jamenaso/PBC_TPF_jmena/PBC_TP_Final_JMena.kicad_pcb

## KiCad design PBC_TP_Final_JMena.kicad_pcb (2018-11-15)

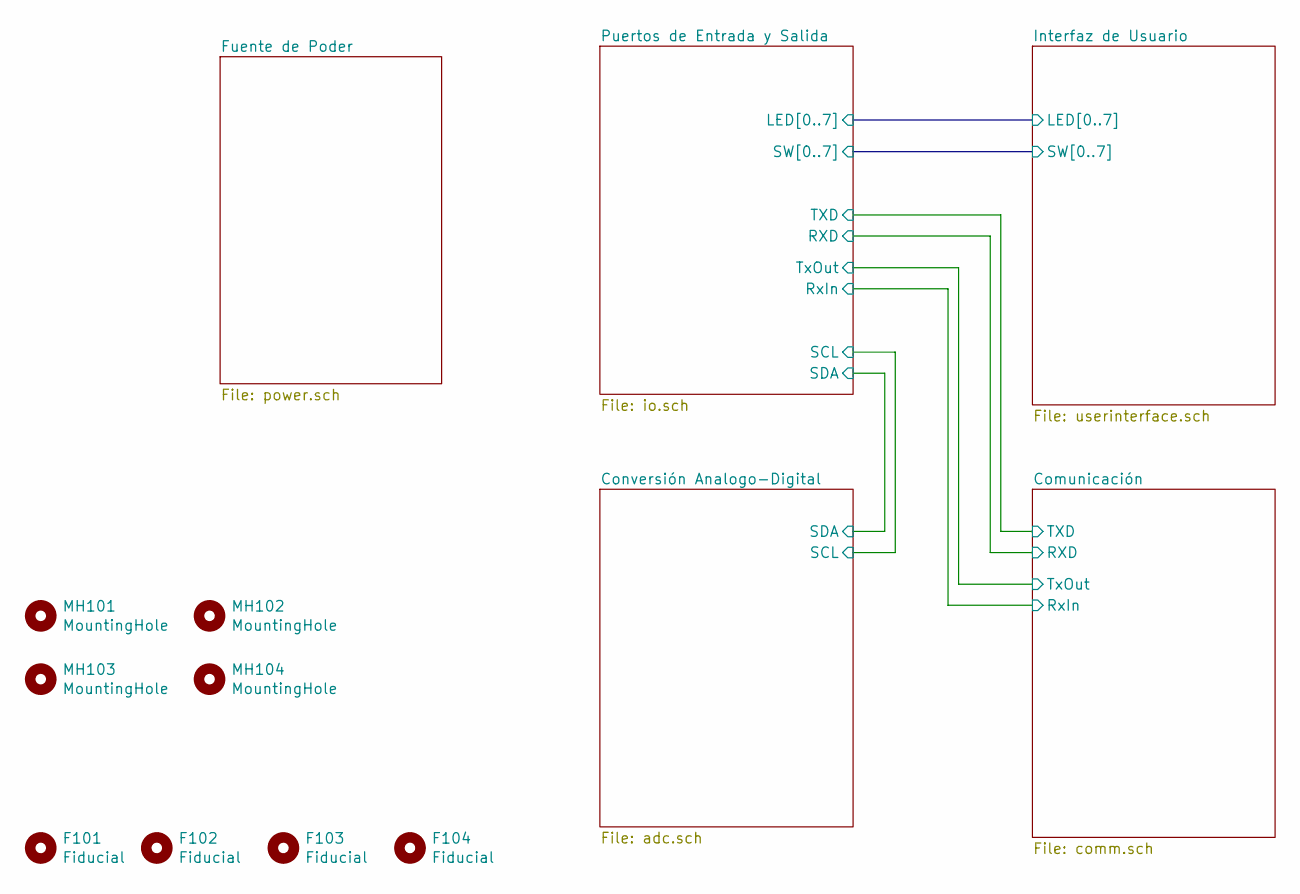
[picture p1: schematic PBC_TP_Final_JMena.sch, PBC TP Final - Tarjeta de Expanción GEO-HCAL]

Parts:
F101, F102, F103, F104: Fiducial; Fiducial_0.75mm_Dia_1.5mm_Outer
MH101, MH102, MH103, MH104: MountingHole; MountingHole_2.5mm

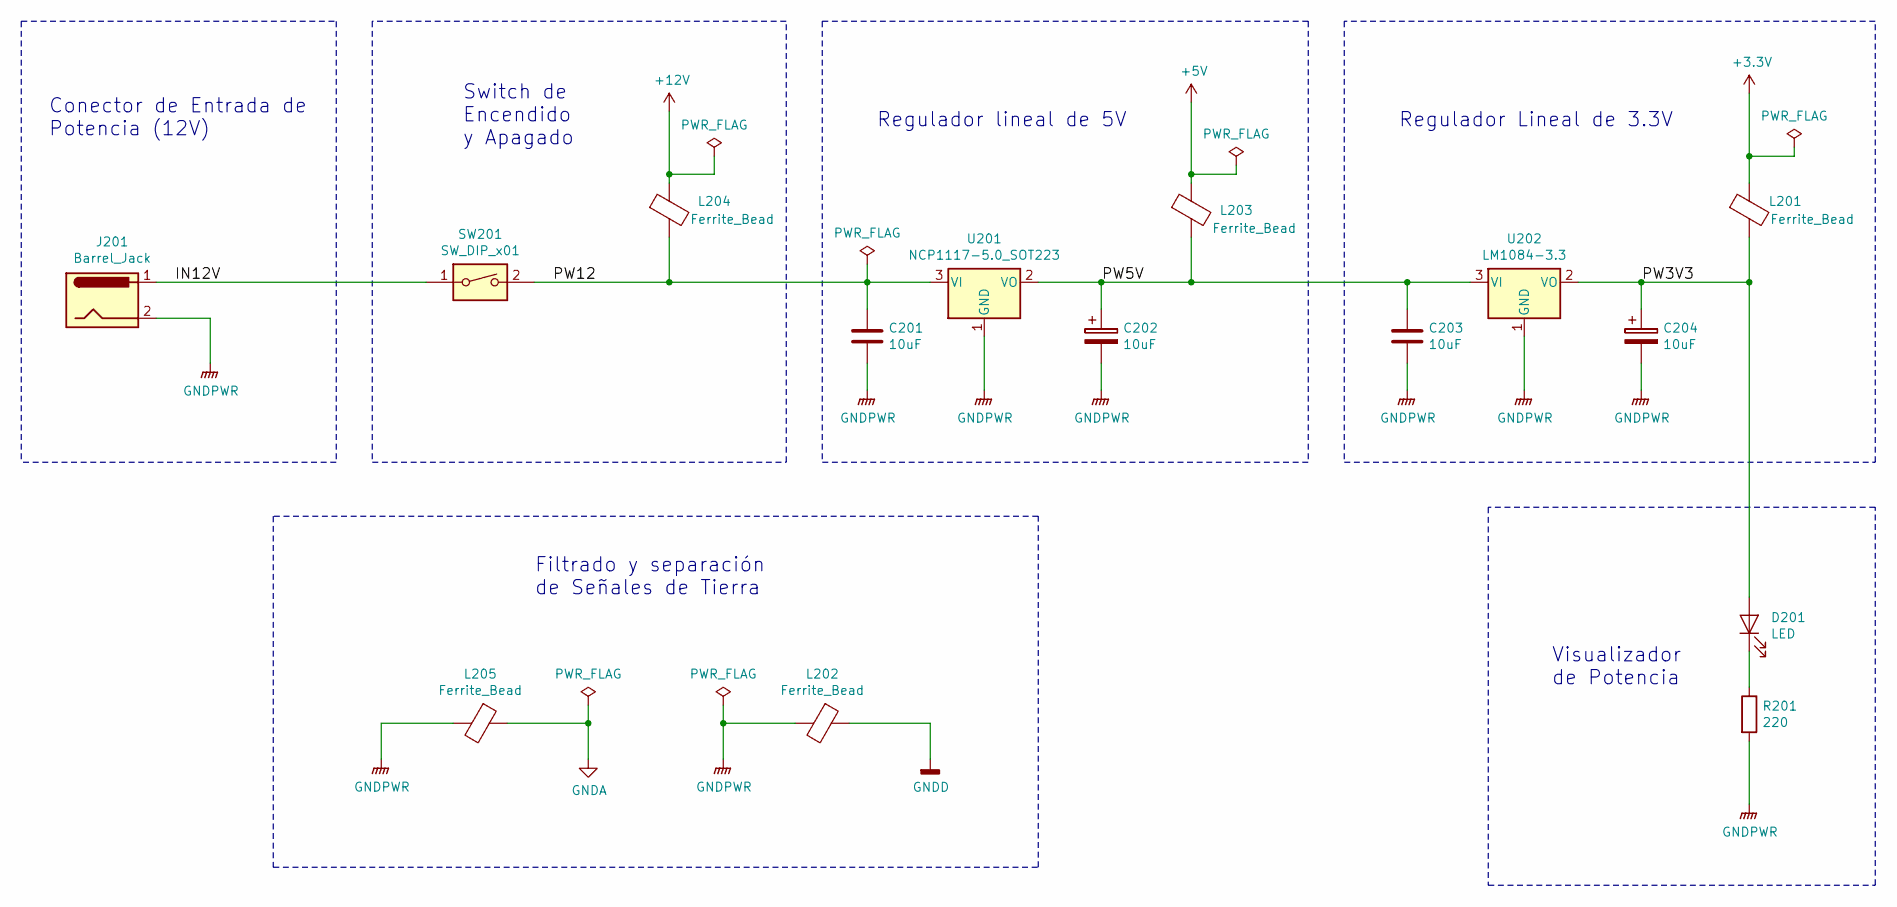
[picture p2: schematic power.sch, PBC TP Final - Tarjeta de Expanción GEO-HCAL]

Parts:
C201, C202, C203, C204: 10uF; C_1206_3216Metric_Pad1.42x1.75mm_HandSolder
D201: LED; LED_0805_2012Metric_Pad1.15x1.40mm_HandSolder
J201: Barrel_Jack; BarrelJack_CUI_PJ-063AH_Horizontal
L201, L202, L203, L204, L205: Ferrite_Bead; L_1206_3216Metric_Pad1.42x1.75mm_HandSolder
R201: 220; R_0805_2012Metric_Pad1.15x1.40mm_HandSolder
SW201: SW_DIP_x01; SW_SPST_EVQPE1
U201: NCP1117-5.0_SOT223; SOT-223-3_TabPin2
U202: LM1084-3.3; TO-263-3_TabPin2

Connections:
+5V: L203.1; also elsewhere on the board
+12V: L204.1; also elsewhere on the board
/Fuente de Poder/IN12V: J201.1, SW201.1
/Fuente de Poder/PW3V3: C204.1, D201.2 (A), L201.2, U202.2 (VO)
/Fuente de Poder/PW5V: C202.1, C203.1, L203.2, U201.2 (VO), U202.3 (VI)
/Fuente de Poder/PW12: C201.1, L204.2, SW201.2, U201.3 (VI)
GNDA: L205.1; also elsewhere on the board
GNDD: L202.1; also elsewhere on the board
GNDPWR: C201.2, C202.2, C203.2, C204.2, J201.2, L202.2, L205.2, R201.2, U201.1 (GND), U202.1 (GND)
unnamed: D201.1 (K), R201.1

Notes on the sheet:
Conector de Entrada de Potencia (12V)
Regulador lineal de 5V
Regulador Lineal de 3.3V
Visualizador de Potencia
Filtrado y separación de Señales de Tierra
Switch de Encendido y Apagado

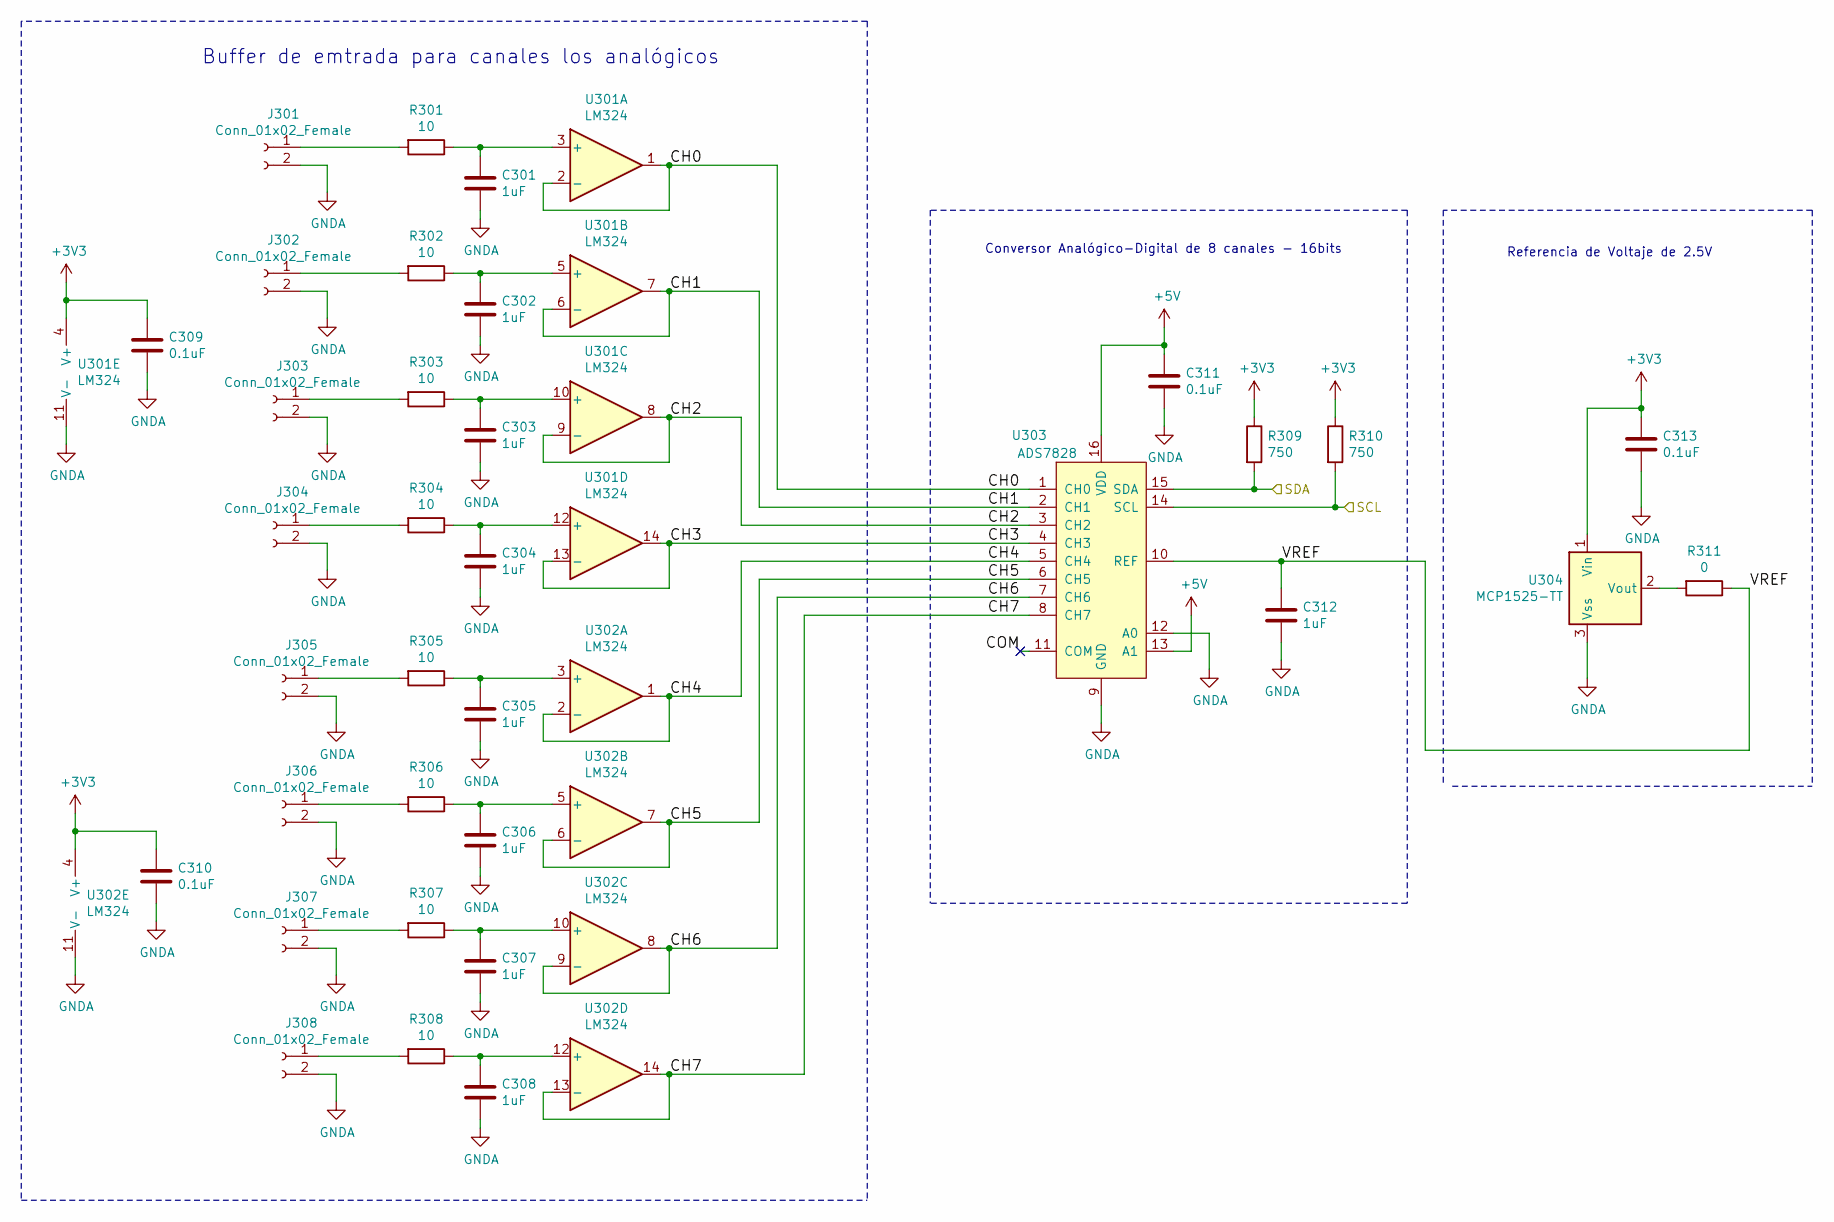
[picture p3: schematic adc.sch, PBC TP Final - Tarjeta de Expanción GEO-HCAL]

Parts:
C301, C302, C303, C304, C305, C306, C307, C308, C312: 1uF; C_0805_2012Metric_Pad1.15x1.40mm_HandSolder
C309, C310, C311, C313: 0.1uF; C_0805_2012Metric_Pad1.15x1.40mm_HandSolder
J301, J302, J303, J304, J305, J306, J307, J308: Conn_01x02_Female; PinHeader_1x02_P1.27mm_Vertical
R301, R302, R303, R304, R305, R306, R307, R308: 10; R_0805_2012Metric_Pad1.15x1.40mm_HandSolder
R309, R310: 750; R_0805_2012Metric_Pad1.15x1.40mm_HandSolder
R311: 0; R_0805_2012Metric_Pad1.15x1.40mm_HandSolder
U301, U302: LM324; SOIC-14_3.9x8.7mm_P1.27mm
U303: ADS7828; TSSOP-16_4.4x5mm_P0.65mm
U304: MCP1525-TT; SOT-23

Connections:
+5V: C311.1, U303.13 (A1), U303.16 (VDD); also elsewhere on the board
/Conversión Analogo-Digital/CH0: U301.1, U301.2 (-), U303.1 (CH0)
/Conversión Analogo-Digital/CH1: U301.6 (-), U301.7, U303.2 (CH1)
/Conversión Analogo-Digital/CH2: U301.8, U301.9 (-), U303.3 (CH2)
/Conversión Analogo-Digital/CH3: U301.13 (-), U301.14, U303.4 (CH3)
/Conversión Analogo-Digital/CH4: U302.1, U302.2 (-), U303.5 (CH4)
/Conversión Analogo-Digital/CH5: U302.6 (-), U302.7, U303.6 (CH5)
/Conversión Analogo-Digital/CH6: U302.8, U302.9 (-), U303.7 (CH6)
/Conversión Analogo-Digital/CH7: U302.13 (-), U302.14, U303.8 (CH7)
/Conversión Analogo-Digital/COM: U303.11 (COM)
/Conversión Analogo-Digital/SCL: R310.2, U303.14 (SCL); also elsewhere on the board
/Conversión Analogo-Digital/SDA: R309.2, U303.15 (SDA); also elsewhere on the board
/Conversión Analogo-Digital/VREF: C312.1, R311.1, U303.10 (REF)
GNDA: C301.2, C302.2, C303.2, C304.2, C305.2, C306.2, C307.2, C308.2, C309.2, C310.2, C311.2, C312.2, C313.2, J301.2, J302.2, J303.2, J304.2, J305.2, J306.2, J307.2, J308.2, U301.11 (V-), U302.11 (V-), U303.9 (GND), U303.12 (A0), U304.3 (Vss); also elsewhere on the board
unnamed: C301.1, R301.1, U301.3 (+)
unnamed: C302.1, R302.1, U301.5 (+)
unnamed: C303.1, R303.1, U301.10 (+)
unnamed: C304.1, R304.1, U301.12 (+)
unnamed: C305.1, R305.1, U302.3 (+)
unnamed: C306.1, R306.1, U302.5 (+)
unnamed: C307.1, R307.1, U302.10 (+)
unnamed: C308.1, R308.1, U302.12 (+)
unnamed: J301.1, R301.2
unnamed: J302.1, R302.2
unnamed: J303.1, R303.2
unnamed: J304.1, R304.2
unnamed: J305.1, R305.2
unnamed: J306.1, R306.2
unnamed: J307.1, R307.2
unnamed: J308.1, R308.2
unnamed: R311.2, U304.2 (Vout)

Notes on the sheet:
Buffer de emtrada para canales los analógicos
Conversor Analógico-Digital de 8 canales - 16bits
Referencia de Voltaje de 2.5V

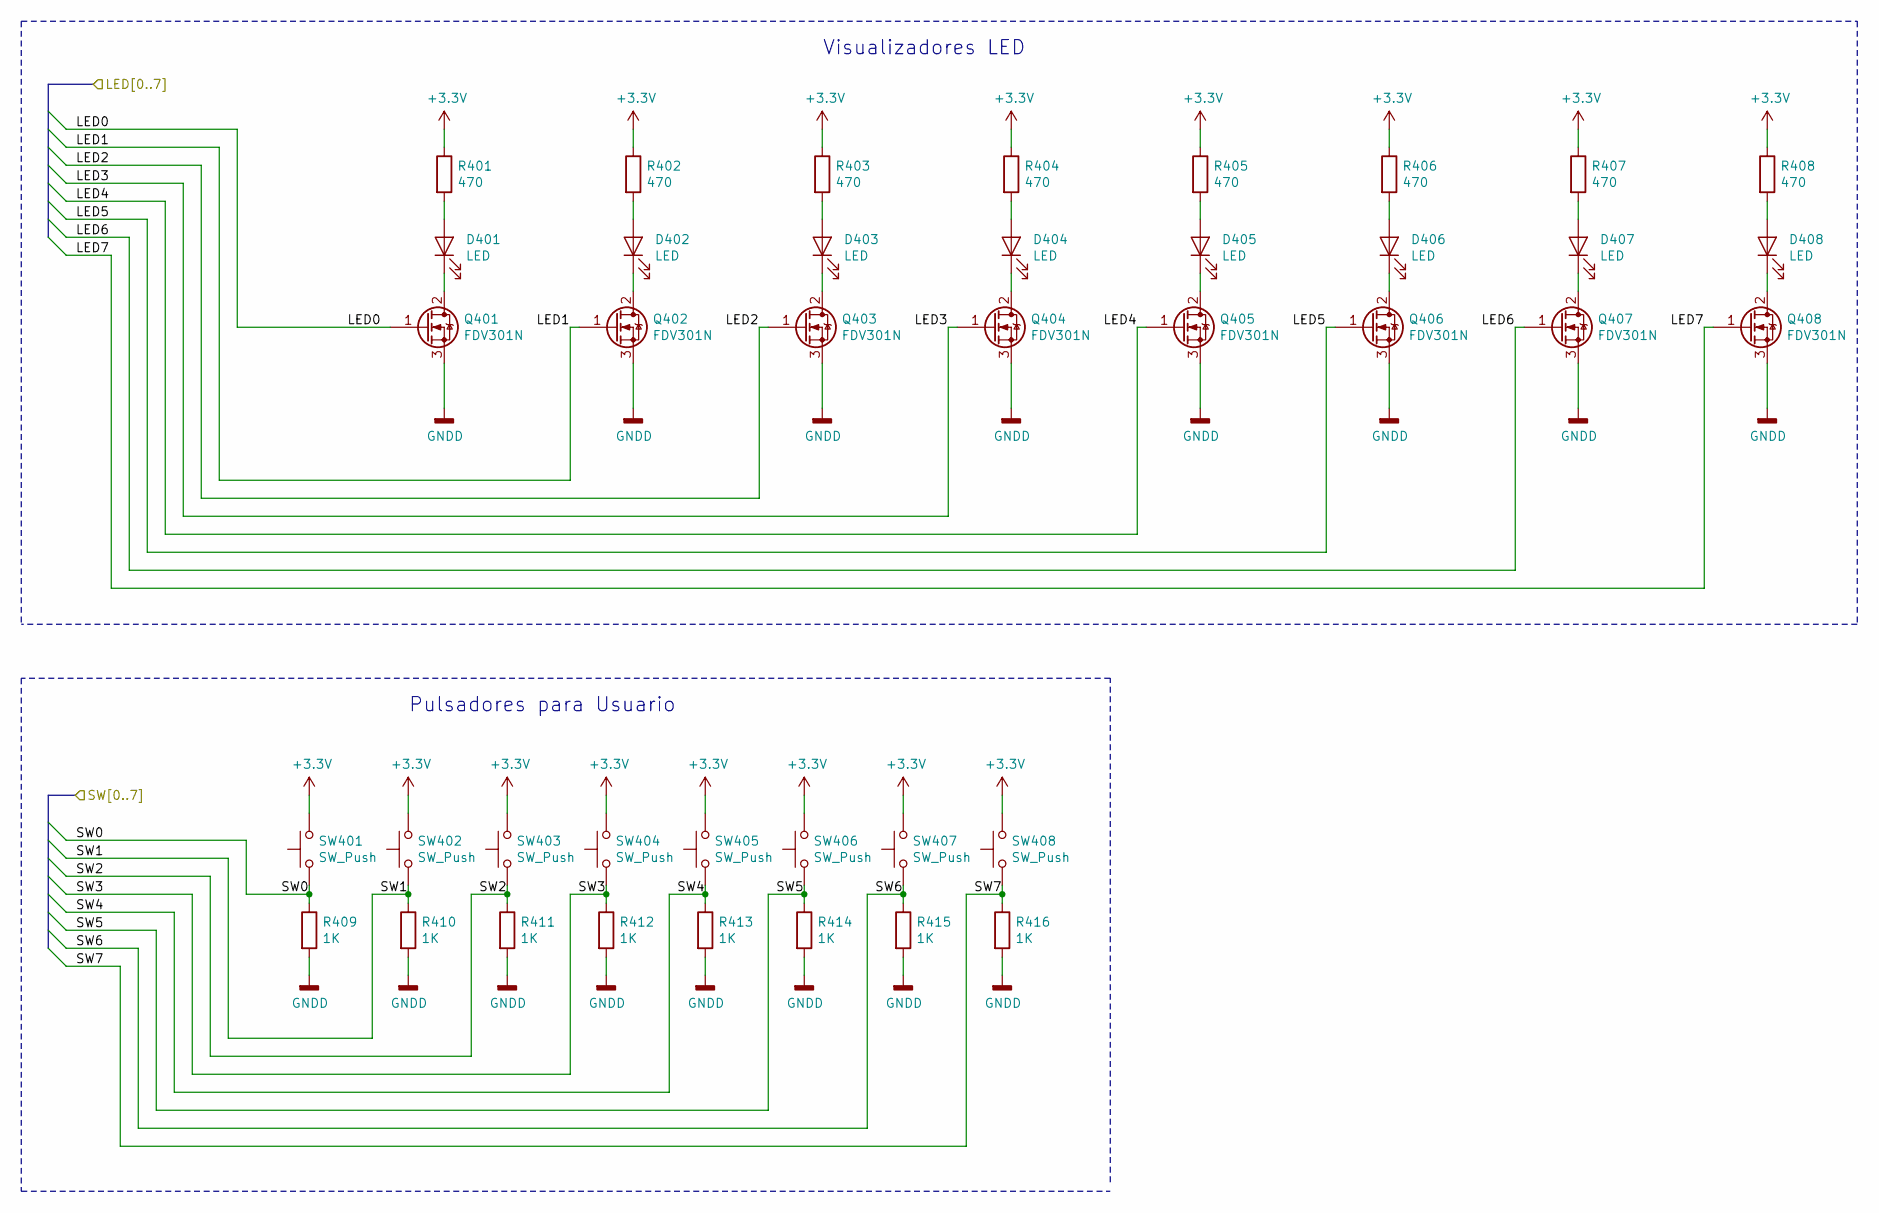
[picture p4: schematic userinterface.sch, PBC TP Final - Tarjeta de Expanción GEO-HCAL]

Parts:
D401, D402, D403, D404, D405, D406, D407, D408: LED; LED_0805_2012Metric_Pad1.15x1.40mm_HandSolder
Q401, Q402, Q403, Q404, Q405, Q406, Q407, Q408: FDV301N; SOT-23
R401, R402, R403, R404, R405, R406, R407, R408: 470; R_0805_2012Metric_Pad1.15x1.40mm_HandSolder
R409, R410, R411, R412, R413, R414, R415, R416: 1K; R_0805_2012Metric_Pad1.15x1.40mm_HandSolder
SW401, SW402, SW403, SW404, SW405, SW406, SW407, SW408: SW_Push; SW_SPST_B3U-1000P

Connections:
/Interfaz de Usuario/LED0: Q401.1 (G); also elsewhere on the board
/Interfaz de Usuario/LED1: Q402.1 (G); also elsewhere on the board
/Interfaz de Usuario/LED2: Q403.1 (G); also elsewhere on the board
/Interfaz de Usuario/LED3: Q404.1 (G); also elsewhere on the board
/Interfaz de Usuario/LED4: Q405.1 (G); also elsewhere on the board
/Interfaz de Usuario/LED5: Q406.1 (G); also elsewhere on the board
/Interfaz de Usuario/LED6: Q407.1 (G); also elsewhere on the board
/Interfaz de Usuario/LED7: Q408.1 (G); also elsewhere on the board
/Interfaz de Usuario/SW0: R409.1, SW401.1; also elsewhere on the board
/Interfaz de Usuario/SW1: R410.1, SW402.1; also elsewhere on the board
/Interfaz de Usuario/SW2: R411.1, SW403.1; also elsewhere on the board
/Interfaz de Usuario/SW3: R412.1, SW404.1; also elsewhere on the board
/Interfaz de Usuario/SW4: R413.1, SW405.1; also elsewhere on the board
/Interfaz de Usuario/SW5: R414.1, SW406.1; also elsewhere on the board
/Interfaz de Usuario/SW6: R415.1, SW407.1; also elsewhere on the board
/Interfaz de Usuario/SW7: R416.1, SW408.1; also elsewhere on the board
GNDD: Q401.3 (S), Q402.3 (S), Q403.3 (S), Q404.3 (S), Q405.3 (S), Q406.3 (S), Q407.3 (S), Q408.3 (S), R409.2, R410.2, R411.2, R412.2, R413.2, R414.2, R415.2, R416.2; also elsewhere on the board
unnamed: D401.1 (K), Q401.2 (D)
unnamed: D401.2 (A), R401.2
unnamed: D402.1 (K), Q402.2 (D)
unnamed: D402.2 (A), R402.2
unnamed: D403.1 (K), Q403.2 (D)
unnamed: D403.2 (A), R403.2
unnamed: D404.1 (K), Q404.2 (D)
unnamed: D404.2 (A), R404.2
unnamed: D405.1 (K), Q405.2 (D)
unnamed: D405.2 (A), R405.2
unnamed: D406.1 (K), Q406.2 (D)
unnamed: D406.2 (A), R406.2
unnamed: D407.1 (K), Q407.2 (D)
unnamed: D407.2 (A), R407.2
unnamed: D408.1 (K), Q408.2 (D)
unnamed: D408.2 (A), R408.2

Notes on the sheet:
Visualizadores LED
Pulsadores para Usuario

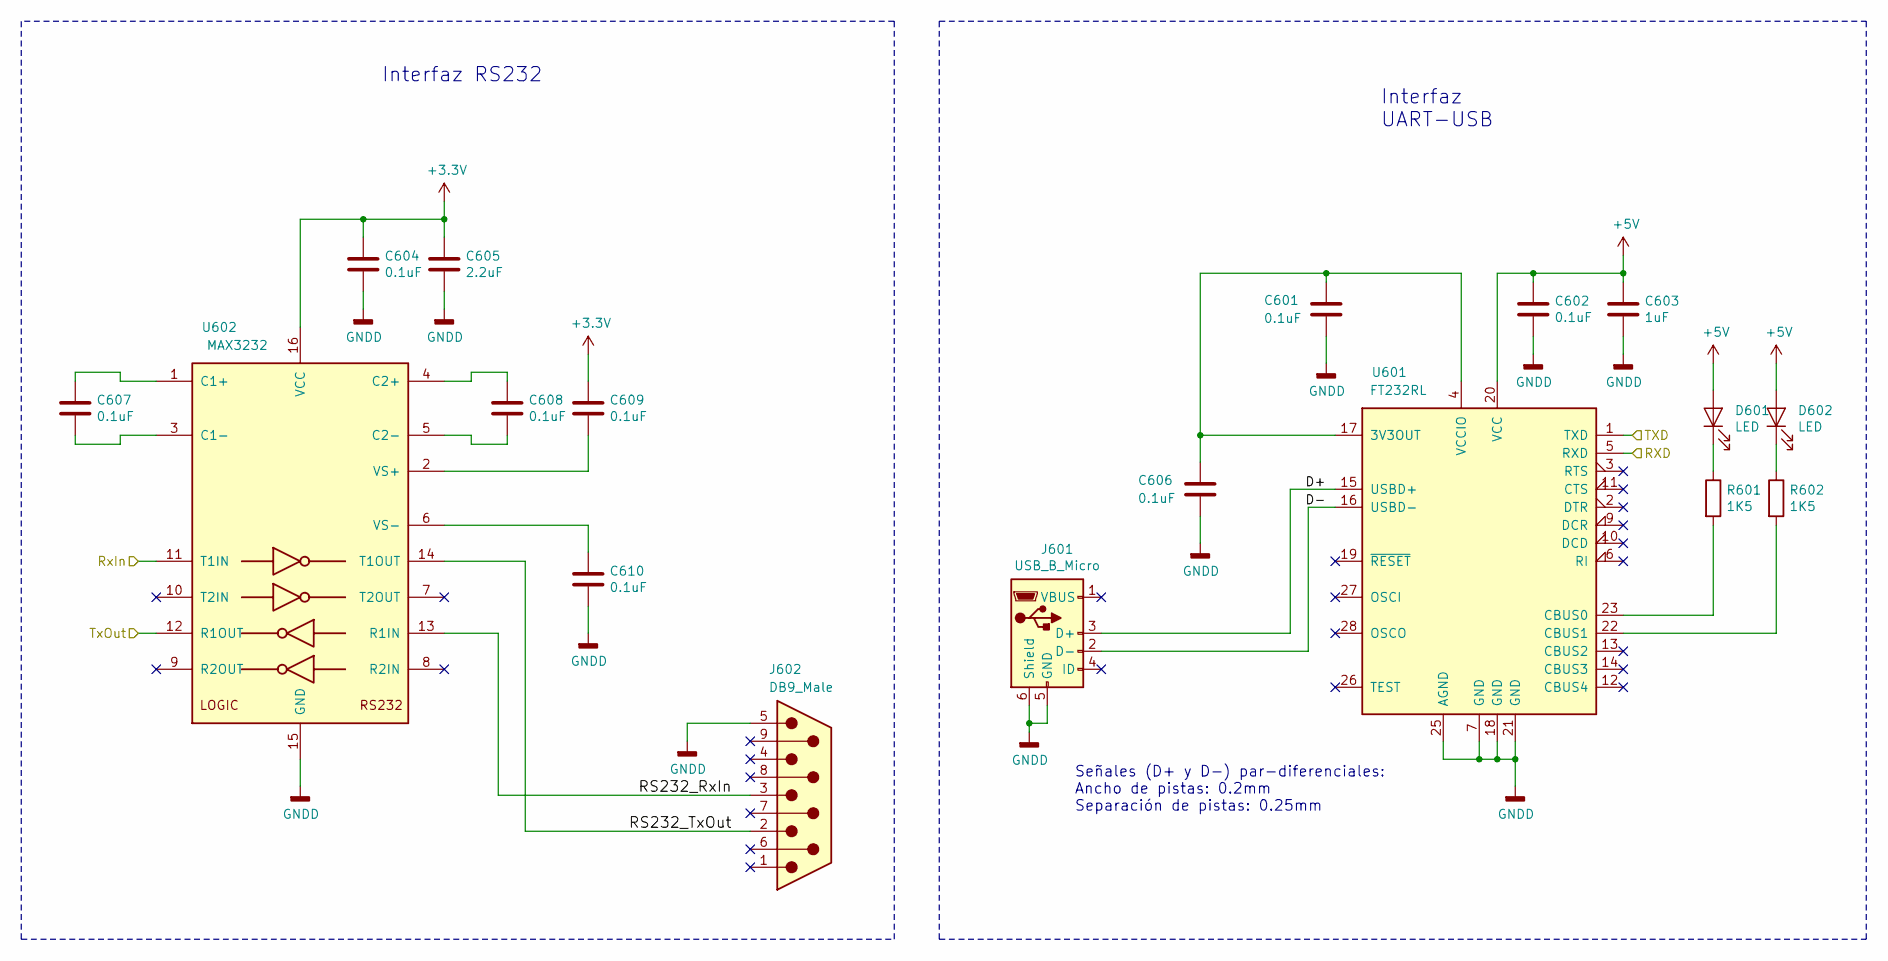
[picture p5: schematic comm.sch, PBC TP Final - Tarjeta de Expanción GEO-HCAL]

Parts:
C601, C602, C604, C606, C607, C608, C609, C610: 0.1uF; C_0805_2012Metric_Pad1.15x1.40mm_HandSolder
C603: 1uF; C_0805_2012Metric_Pad1.15x1.40mm_HandSolder
C605: 2.2uF; C_1206_3216Metric_Pad1.42x1.75mm_HandSolder
D601, D602: LED; LED_0805_2012Metric_Pad1.15x1.40mm_HandSolder
J601: USB_B_Micro; USB_Micro-B_Molex_47346-0001
J602: DB9_Male; DSUB-9_Male_Horizontal_P2.77x2.84mm_EdgePinOffset4.94mm_Hou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
R601, R602: 1K5; R_0805_2012Metric_Pad1.15x1.40mm_HandSolder
U601: FT232RL; SSOP-28_5.3x10.2mm_P0.65mm
U602: MAX3232; SOIC-16_3.9x9.9mm_P1.27mm

Connections:
+5V: C602.1, C603.1, D601.2 (A), D602.2 (A), U601.20 (VCC); also elsewhere on the board
/Comunicación/D+: J601.3 (D+), U601.15 (USBD+)
/Comunicación/D-: J601.2 (D-), U601.16 (USBD-)
/Comunicación/RS232_RxIn: J602.3, U602.13 (R1IN)
/Comunicación/RS232_TxOut: J602.2, U602.14 (T1OUT)
/Comunicación/RXD: U601.5 (RXD); also elsewhere on the board
/Comunicación/RxIn: U602.11 (T1IN); also elsewhere on the board
/Comunicación/TXD: U601.1 (TXD); also elsewhere on the board
/Comunicación/TxOut: U602.12 (R1OUT); also elsewhere on the board
GNDD: C601.2, C602.2, C603.2, C604.2, C605.2, C606.2, C610.2, J601.5 (GND), J601.6 (Shield), J602.5, U601.7 (GND), U601.18 (GND), U601.21 (GND), U601.25 (AGND), U602.15 (GND); also elsewhere on the board
unnamed: C601.1, C606.1, U601.4 (VCCIO), U601.17 (3V3OUT)
unnamed: C607.1, U602.1 (C1+)
unnamed: C607.2, U602.3 (C1-)
unnamed: C608.1, U602.4 (C2+)
unnamed: C608.2, U602.5 (C2-)
unnamed: C609.2, U602.2 (VS+)
unnamed: C610.1, U602.6 (VS-)
unnamed: D601.1 (K), R601.1
unnamed: D602.1 (K), R602.1
unnamed: R601.2, U601.23 (CBUS0)
unnamed: R602.2, U601.22 (CBUS1)

Notes on the sheet:
Interfaz RS232
Interfaz UART-USB
Señales (D+ y D-) par-diferenciales: Ancho de pistas: 0.2mm Separación de pistas: 0.25mm

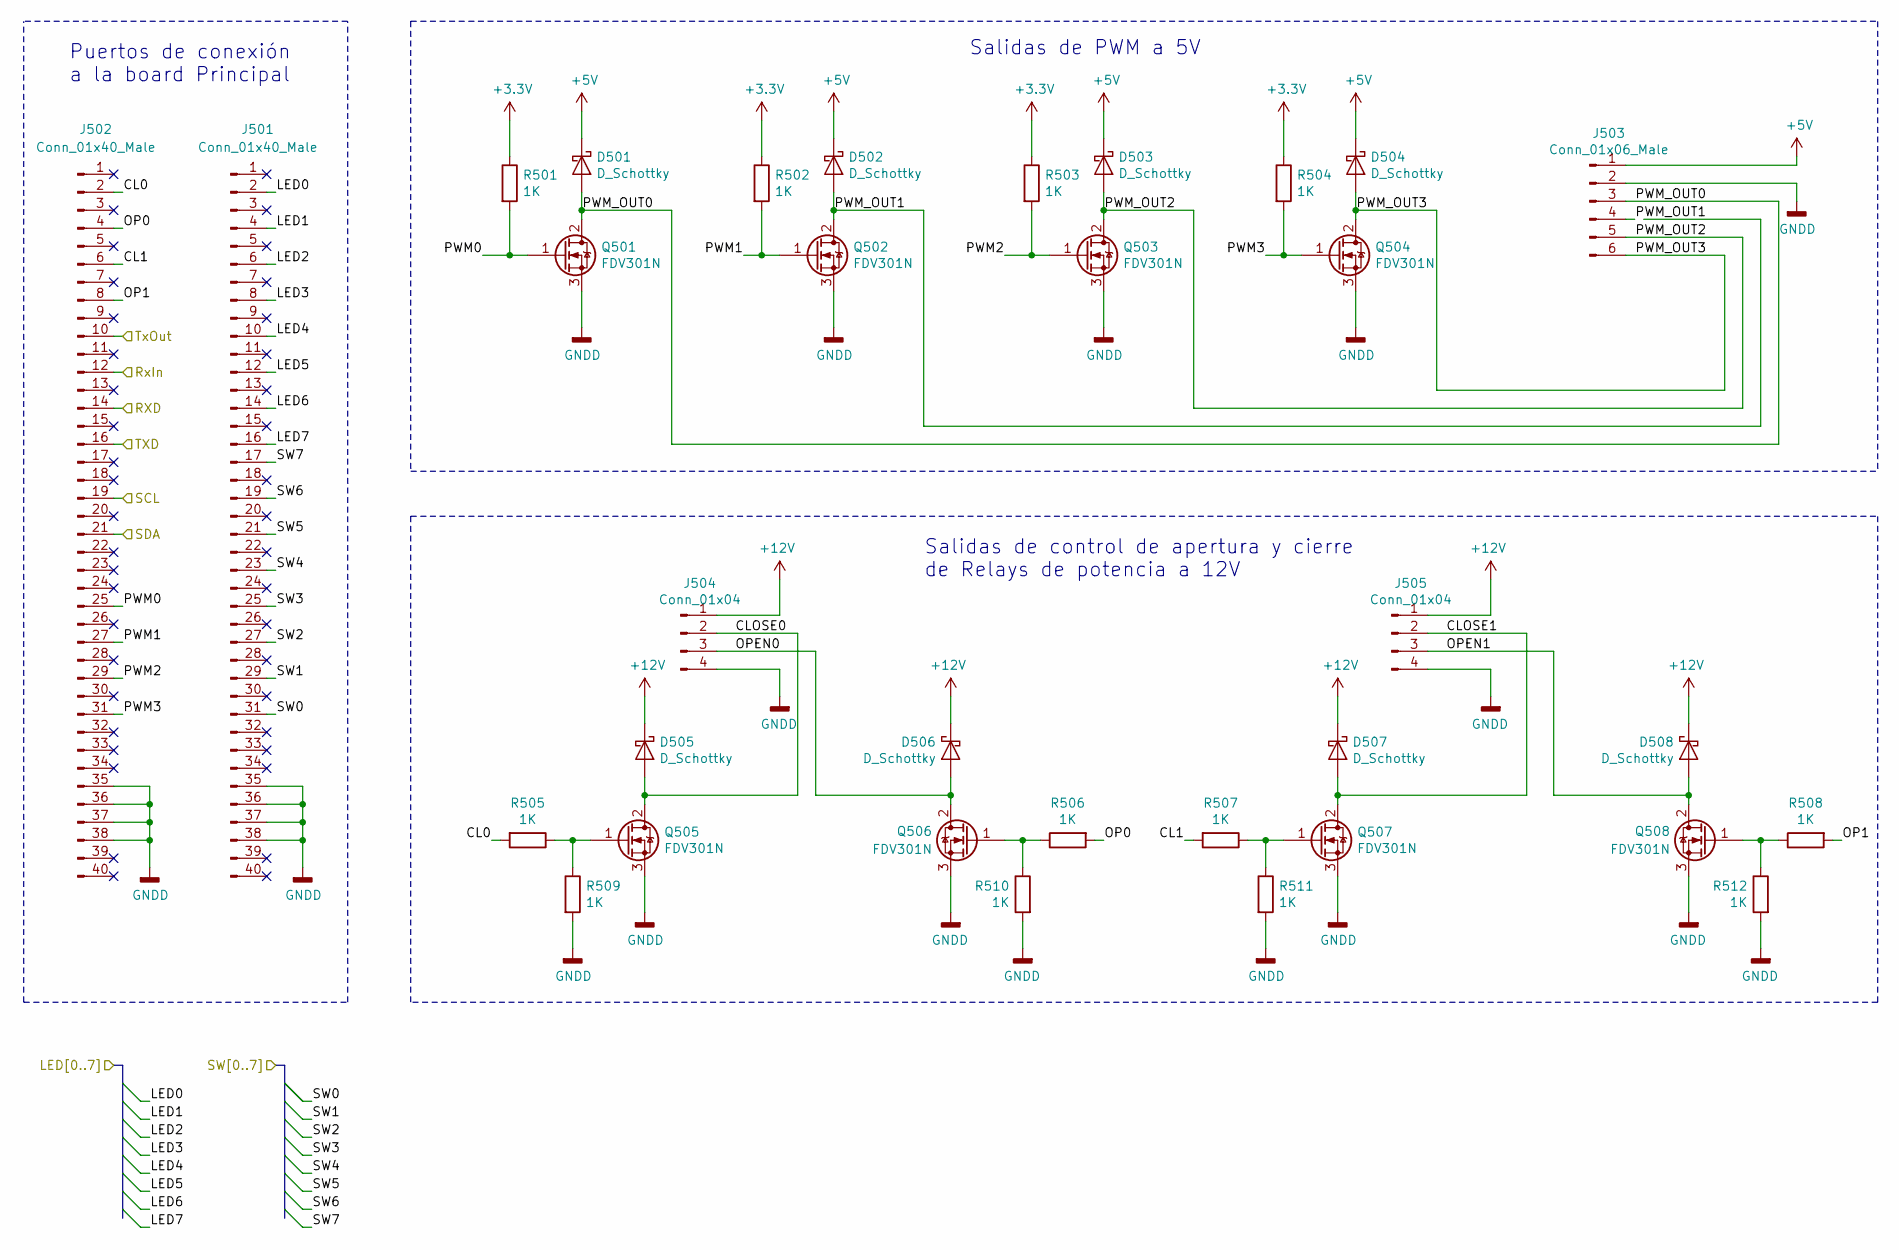
[picture p6: schematic io.sch, PBC TP Final - Tarjeta de Expanción GEO-HCAL]

Parts:
D501, D502, D503, D504, D505, D506, D507, D508: D_Schottky; D_0805_2012Metric_Pad1.15x1.40mm_HandSolder
J501, J502: Conn_01x40_Male; PinHeader_2x20_P1.00mm_Vertical
J503: Conn_01x06_Male; PinHeader_1x06_P1.27mm_Vertical
J504, J505: Conn_01x04; PinHeader_1x04_P1.27mm_Vertical
Q501, Q502, Q503, Q504, Q505, Q506, Q507, Q508: FDV301N; SOT-23
R501, R502, R503, R504, R505, R506, R507, R508, R509, R510, R511, R512: 1K; R_0805_2012Metric_Pad1.15x1.40mm_HandSolder

Connections:
+5V: D501.1 (K), D502.1 (K), D503.1 (K), D504.1 (K), J503.1; also elsewhere on the board
+12V: D505.1 (K), D506.1 (K), D507.1 (K), D508.1 (K), J504.1, J505.1; also elsewhere on the board
/Comunicación/RXD: J502.14; also elsewhere on the board
/Comunicación/RxIn: J502.12; also elsewhere on the board
/Comunicación/TXD: J502.16; also elsewhere on the board
/Comunicación/TxOut: J502.10; also elsewhere on the board
/Conversión Analogo-Digital/SCL: J502.19; also elsewhere on the board
/Conversión Analogo-Digital/SDA: J502.21; also elsewhere on the board
/Interfaz de Usuario/LED0: J501.2; also elsewhere on the board
/Interfaz de Usuario/LED1: J501.4; also elsewhere on the board
/Interfaz de Usuario/LED2: J501.6; also elsewhere on the board
/Interfaz de Usuario/LED3: J501.8; also elsewhere on the board
/Interfaz de Usuario/LED4: J501.10; also elsewhere on the board
/Interfaz de Usuario/LED5: J501.12; also elsewhere on the board
/Interfaz de Usuario/LED6: J501.14; also elsewhere on the board
/Interfaz de Usuario/LED7: J501.16; also elsewhere on the board
/Interfaz de Usuario/SW0: J501.31; also elsewhere on the board
/Interfaz de Usuario/SW1: J501.29; also elsewhere on the board
/Interfaz de Usuario/SW2: J501.27; also elsewhere on the board
/Interfaz de Usuario/SW3: J501.25; also elsewhere on the board
/Interfaz de Usuario/SW4: J501.23; also elsewhere on the board
/Interfaz de Usuario/SW5: J501.21; also elsewhere on the board
/Interfaz de Usuario/SW6: J501.19; also elsewhere on the board
/Interfaz de Usuario/SW7: J501.17; also elsewhere on the board
/Puertos de Entrada y Salida/CL0: J502.2, R505.2
/Puertos de Entrada y Salida/CL1: J502.6, R507.2
/Puertos de Entrada y Salida/CLOSE0: D505.2 (A), J504.2, Q505.2 (D)
/Puertos de Entrada y Salida/CLOSE1: D507.2 (A), J505.2, Q507.2 (D)
/Puertos de Entrada y Salida/OP0: J502.4, R506.2
/Puertos de Entrada y Salida/OP1: J502.8, R508.2
/Puertos de Entrada y Salida/OPEN0: D506.2 (A), J504.3, Q506.2 (D)
/Puertos de Entrada y Salida/OPEN1: D508.2 (A), J505.3, Q508.2 (D)
/Puertos de Entrada y Salida/PWM0: J502.25, Q501.1 (G), R501.2
/Puertos de Entrada y Salida/PWM1: J502.27, Q502.1 (G), R502.2
/Puertos de Entrada y Salida/PWM2: J502.29, Q503.1 (G), R503.2
/Puertos de Entrada y Salida/PWM3: J502.31, Q504.1 (G), R504.2
/Puertos de Entrada y Salida/PWM_OUT0: D501.2 (A), J503.3, Q501.2 (D)
/Puertos de Entrada y Salida/PWM_OUT1: D502.2 (A), J503.4, Q502.2 (D)
/Puertos de Entrada y Salida/PWM_OUT2: D503.2 (A), J503.5, Q503.2 (D)
/Puertos de Entrada y Salida/PWM_OUT3: D504.2 (A), J503.6, Q504.2 (D)
GNDD: J501.35, J501.36, J501.37, J501.38, J502.35, J502.36, J502.37, J502.38, J503.2, J504.4, J505.4, Q501.3 (S), Q502.3 (S), Q503.3 (S), Q504.3 (S), Q505.3 (S), Q506.3 (S), Q507.3 (S), Q508.3 (S), R509.2, R510.2, R511.2, R512.2; also elsewhere on the board
unnamed: Q505.1 (G), R505.1, R509.1
unnamed: Q506.1 (G), R506.1, R510.1
unnamed: Q507.1 (G), R507.1, R511.1
unnamed: Q508.1 (G), R508.1, R512.1

Notes on the sheet:
Puertos de conexión a la board Principal
Salidas de PWM a 5V
Salidas de control de apertura y cierre de Relays de potencia a 12V

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
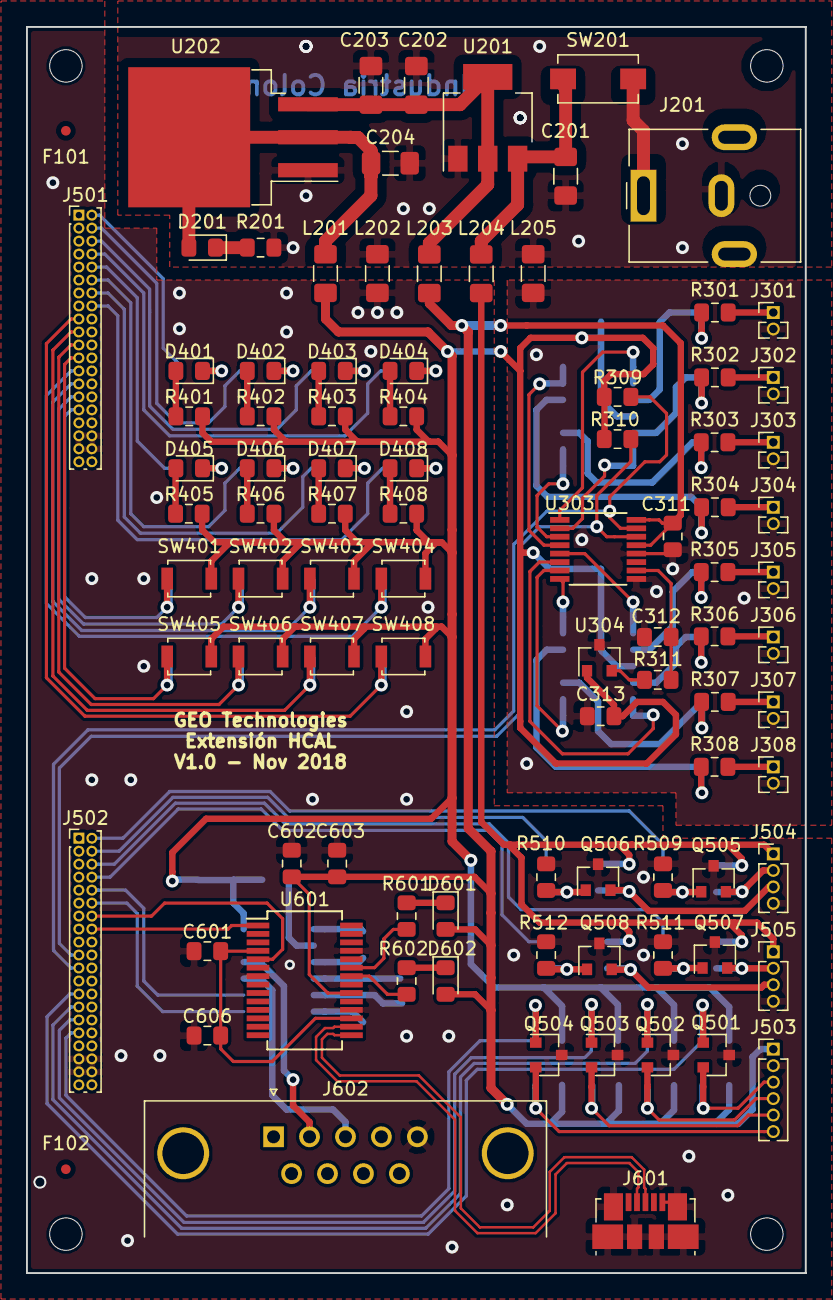
[picture p7: board PBC_TP_Final_JMena.kicad_pcb from above]

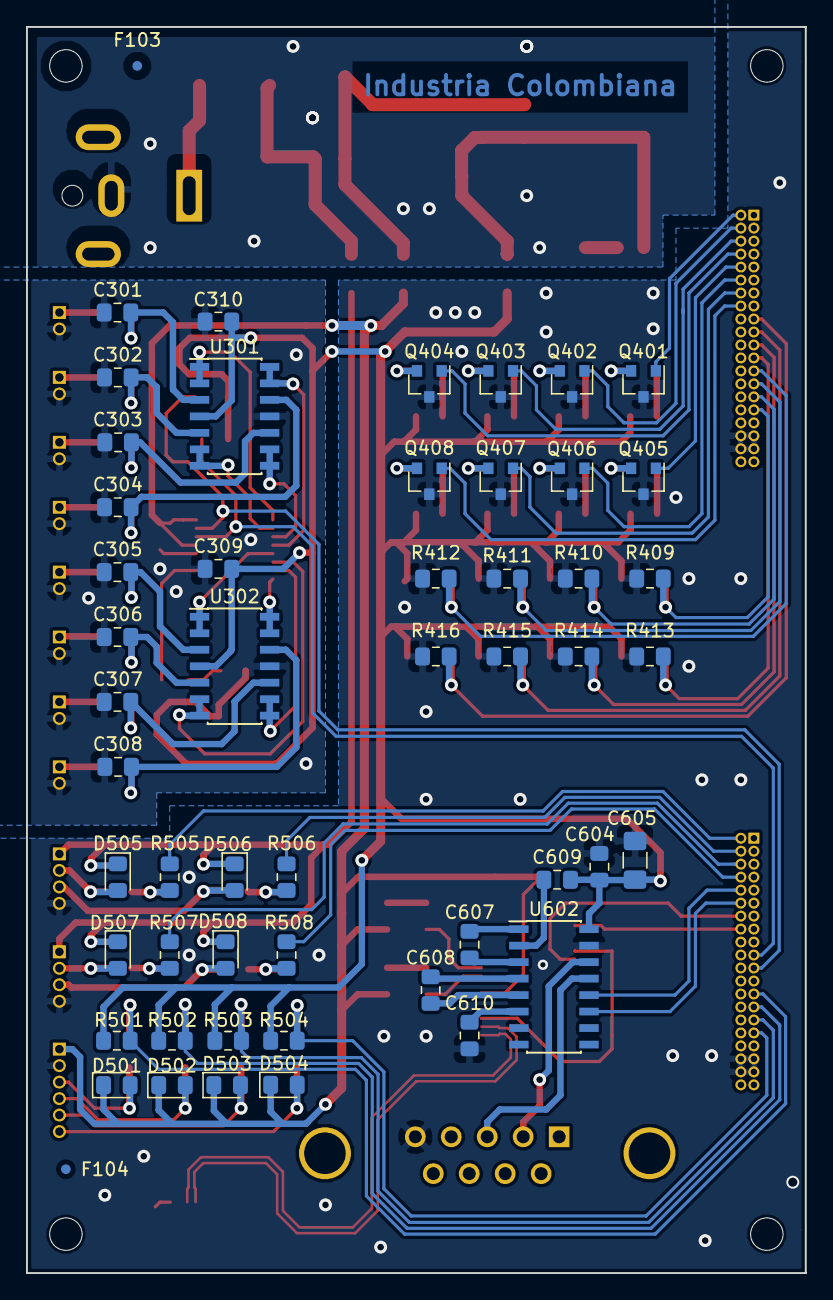
[picture p8: board PBC_TP_Final_JMena.kicad_pcb from below]

Board: 2 copper layers, 60.0 x 96.0 mm, 150 parts (53 on the bottom side), 110 nets.
