jamenaso/PBC_TPF_jmena/(commit log)

2018-09-25 Se crea el repositorio con archivo esquematico
    [PBC_TP_Final_JMena.kicad_pcb, PBC_TP_Final_JMena.sch, adc.sch, comm.sch, io.sch, power.sch, userinterface.sch]
2018-10-17 Se hace cambios en el esquematico y se anexa PCB
    [PBC_TP_Final_JMena.kicad_pcb, PBC_TP_Final_JMena.sch, adc.sch, comm.sch, io.sch, power.sch, userinterface.sch]
2018-10-17 Se agrega plantilla
    [Plantilla de revisión CESE18.xlsx]
2018-11-15 Se realizan correcciones finales y se agregan carpetas BOM, Datasheet, Doc, Gerbers, lib.pretty y shapes3D
    [PBC_TP_Final_JMena-B.Cu.gbr, PBC_TP_Final_JMena-B.Fab.gbr, PBC_TP_Final_JMena-B.Mask.gbr, PBC_TP_Final_JMena-B.Paste.gbr, PBC_TP_Final_JMena-B.SilkS.gbr, PBC_TP_Final_JMena-Dwgs.User.gbr, PBC_TP_Final_JMena-Edge.Cuts.gbr, PBC_TP_Final_JMena-F.Cu.gbr]
